Artphys333x/laserLBLroboticdipper/Zaber to Slide Spinner Plate.pdf

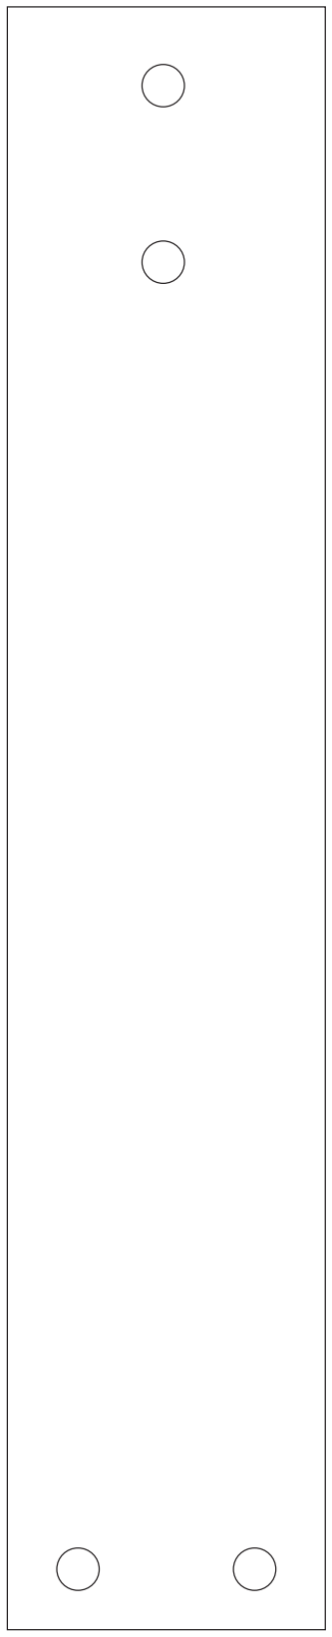
[picture p1: figure]
