Artphys333x/laserLBLroboticdipper/irbracket.pdf

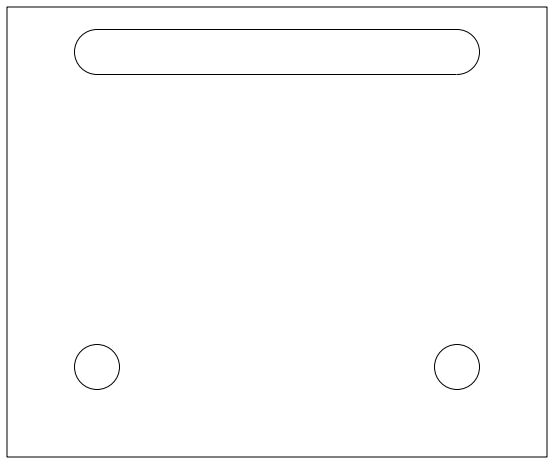
[picture p2: figure]
