Artphys333x/laserLBLroboticdipper/ZaberServo.stl

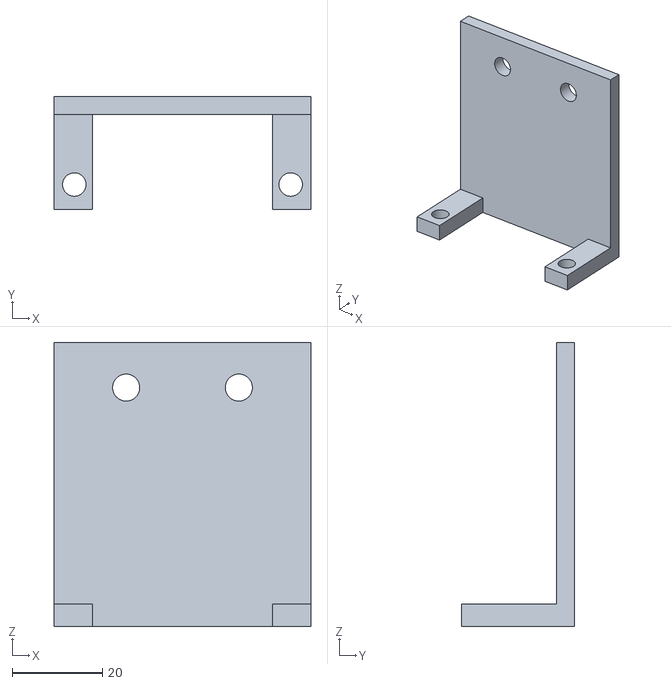
[picture p4: CAD file, 2024-05-31]
ZaberServo.stl
57.0 x 25.0 x 63.0
