Artphys333x/laserLBLroboticdipper/Slideholder.stl

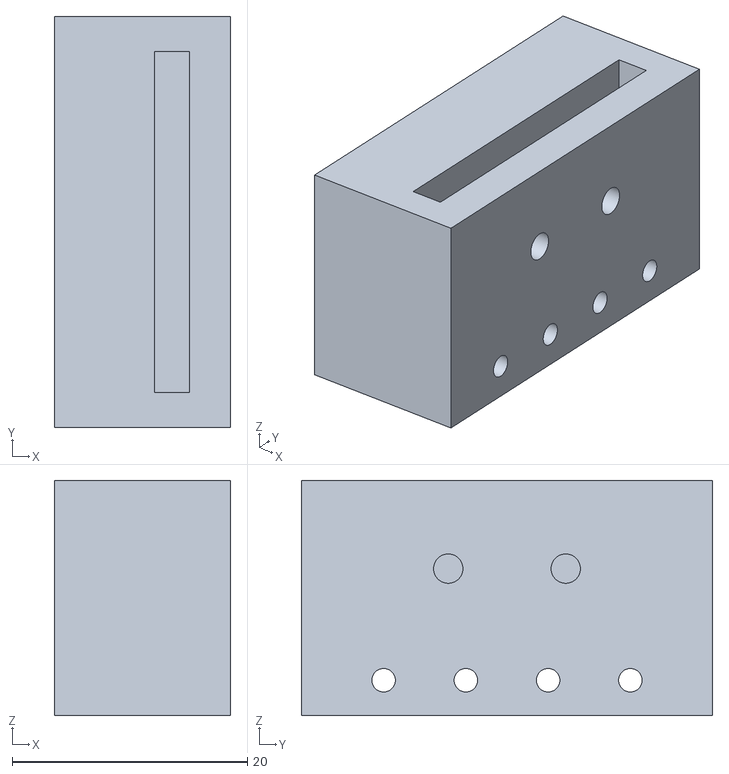
[picture p5: CAD file, 2024-05-31]
Slideholder.stl
15.0 x 35.0 x 20.0
