Artphys333x/laserLBLroboticdipper/turntable.stl

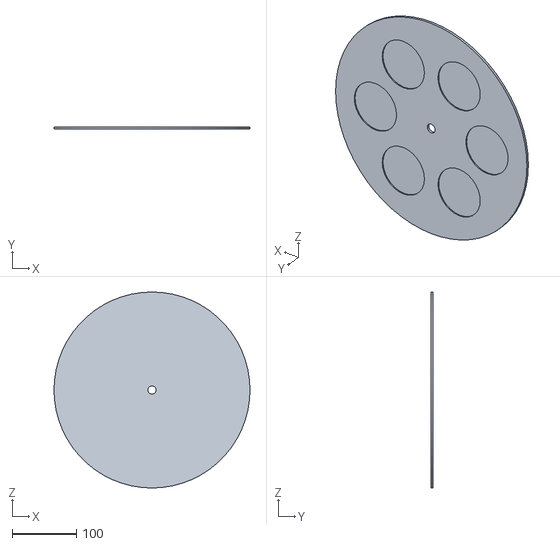
[picture p6: CAD file, 2024-05-31]
turntable.stl
304.8 x 3.17 x 304.8
