Artphys333x/laserLBLroboticdipper/irbracket.stl

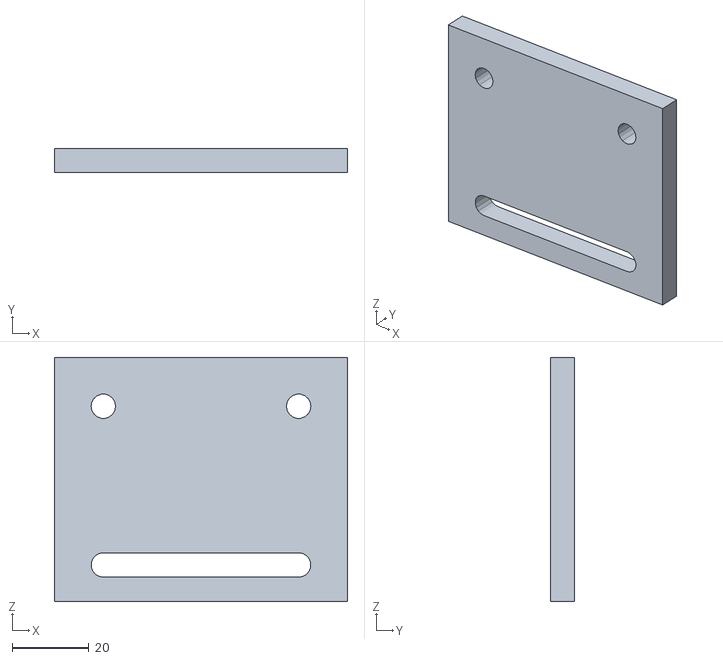
[picture p7: CAD file, 2024-05-31]
irbracket.stl
76.2 x 6.35 x 63.5
