Artphys333x/laserLBLroboticdipper/beakerconverter.stl

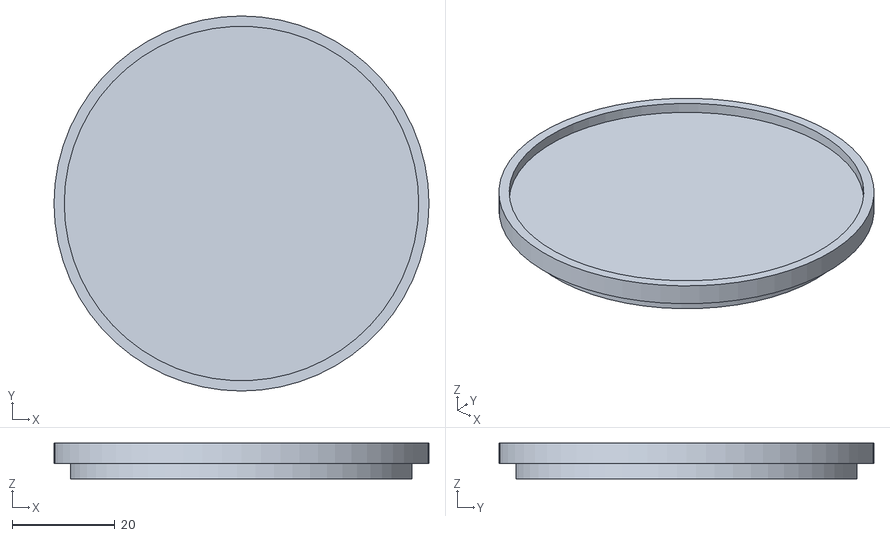
[picture p8: CAD file, 2024-05-31]
beakerconverter.stl
73.0 x 73.0 x 7.00
