Artphys333x/laserLBLroboticdipper/BaseSquare.stl

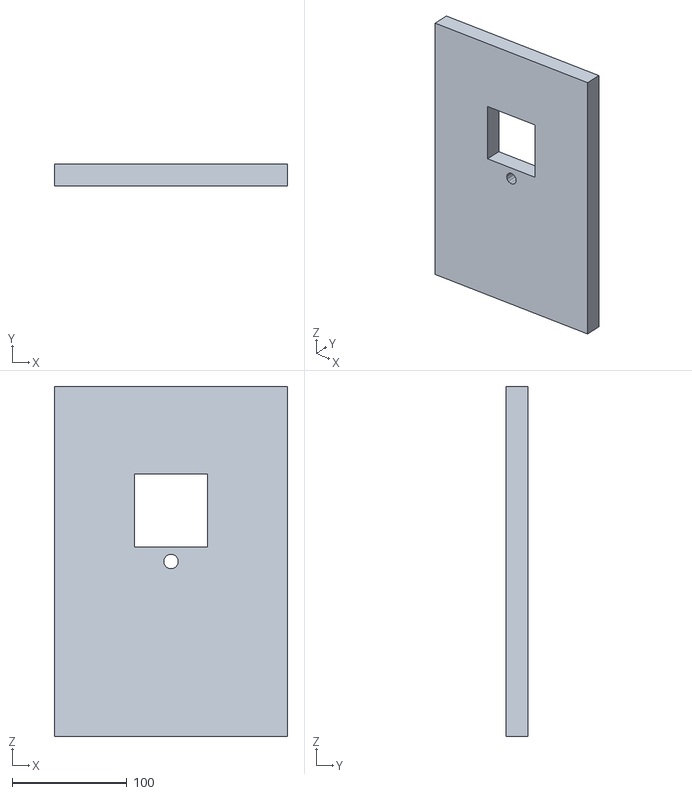
[picture p9: CAD file, 2024-05-31]
BaseSquare.stl
203.2 x 19.0 x 304.8
