Artphys333x/laserLBLroboticdipper/linearactuatorservo.stl

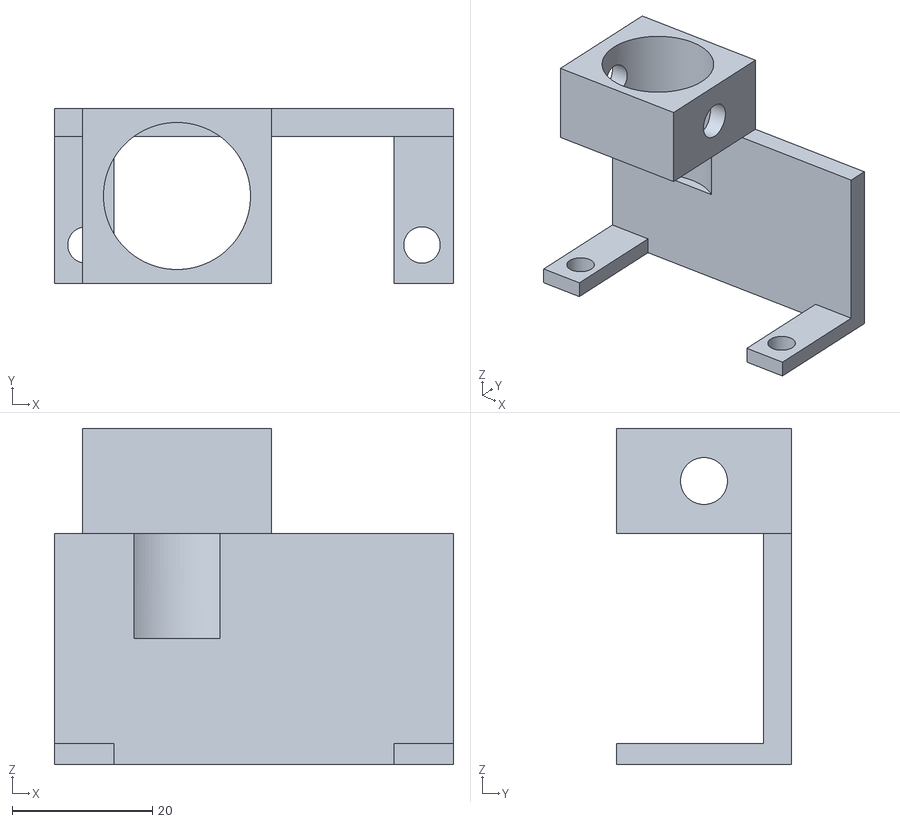
[picture p10: CAD file, 2022-05-11]
linearactuatorservo.stl
57.0 x 25.0 x 48.0
