Artphys333x/laserLBLroboticdipper/irholder.stl

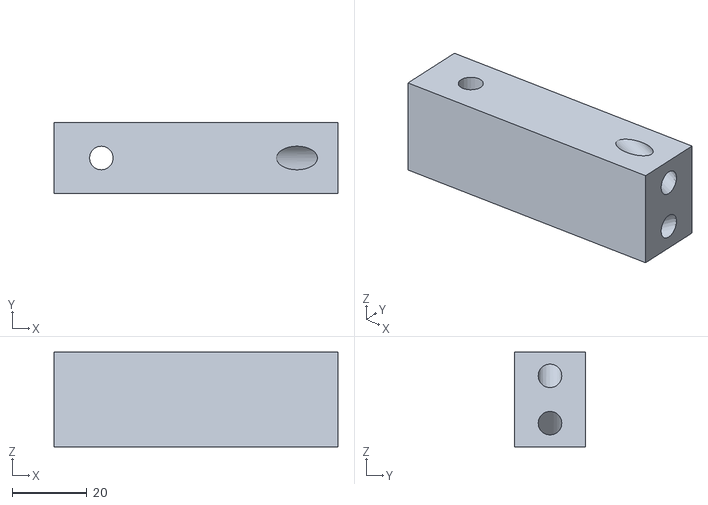
[picture p11: CAD file, 2022-05-11]
irholder.stl
76.2 x 19.0 x 25.4
