Artphys333x/laserLBLroboticdipper/(commit log)

2022-05-11 Added stl files for some of 3d printed parts
    [irholder.stl, linearactuatorservo.stl]
2022-05-13 robot parts and wiring schematic original files
2024-06-11 Delete Supplementary Materials Low Cost Robo.pdf
    Replaced with updated version (now called part list)
